MoodInBME/Hardware-Connections/enclosure/cad/MoodIN_Ver5.stp

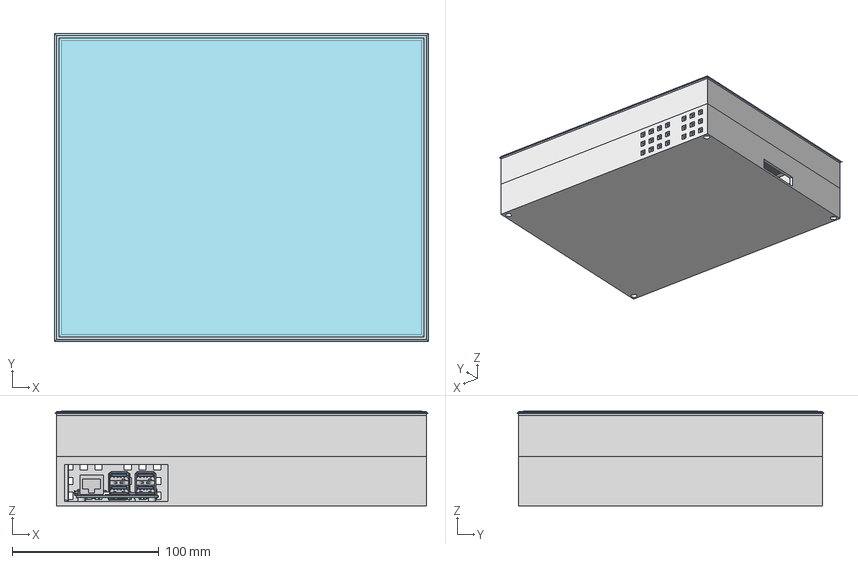
[picture p2: CAD file, 2026-07-27]
enclosure/cad/MoodIN_Ver5.stp
255.0 x 210.0 x 64.5 mm
IMX477_ElectronicCard
IMX477_BasisCamera
