MoodInBME/Hardware-Connections/enclosure/stl/top_frame01.stl

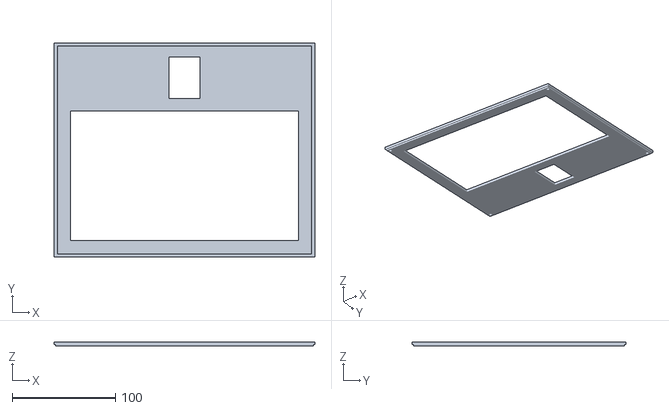
[picture p3: CAD file, 2026-07-26]
enclosure/stl/top_frame01.stl
252.3 x 207.3 x 4.30
