MoodInBME/Hardware-Connections/enclosure/cad/Top_Frame (3).stp

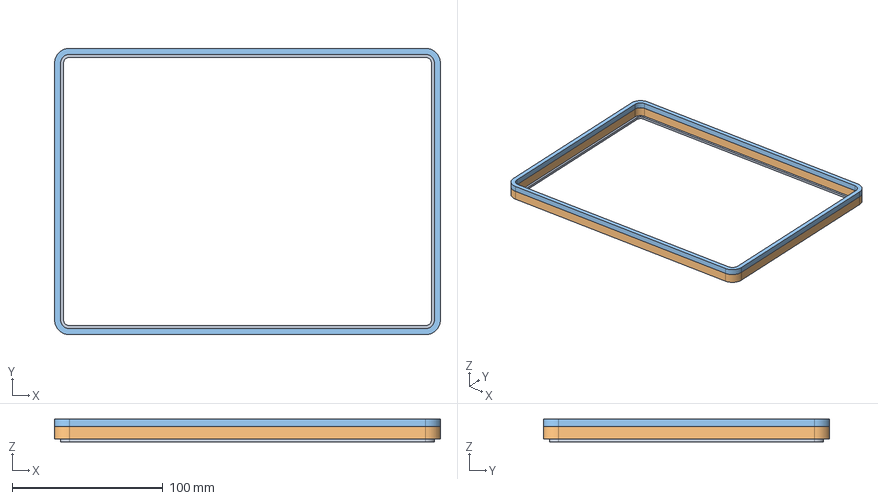
[picture p4: CAD file, 2026-07-23]
enclosure/cad/Top_Frame (3).stp
256.0 x 190.0 x 15.0 mm
