MoodInBME/Hardware-Connections/enclosure/stl/mid_frame01.stl

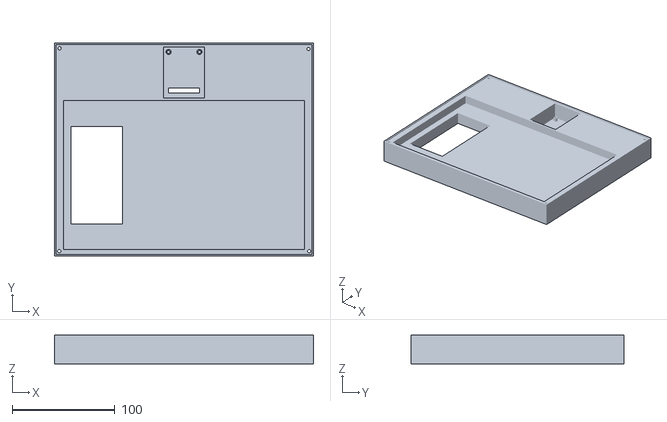
[picture p5: CAD file, 2026-07-26]
enclosure/stl/mid_frame01.stl
252.3 x 207.3 x 28.0
