MoodInBME/Hardware-Connections/enclosure/stl/body_enclosure11.stl

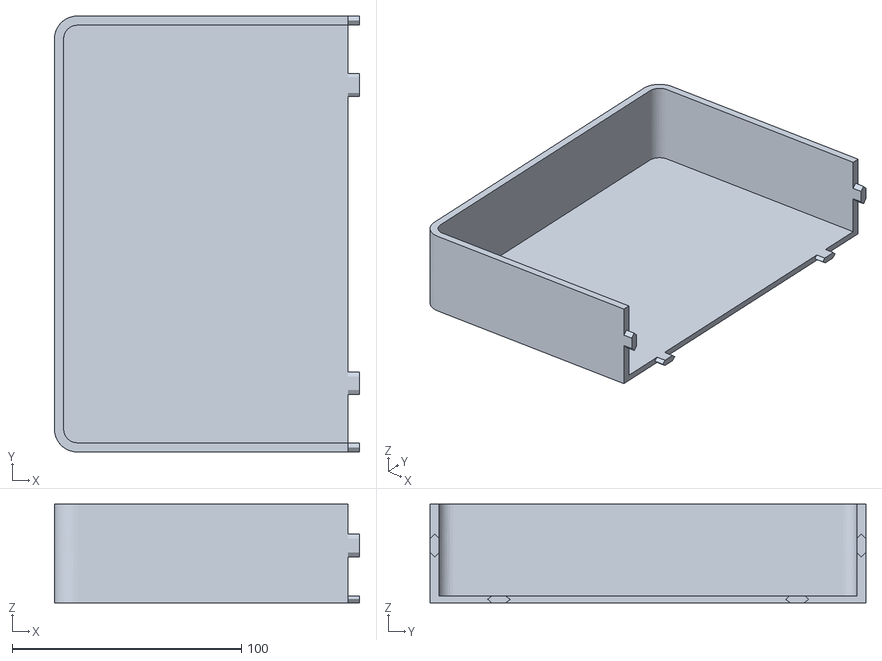
[picture p6: CAD file, 2026-07-24]
enclosure/stl/body_enclosure11.stl
133.0 x 190.0 x 43.0
