MoodInBME/Hardware-Connections/enclosure/stl/body_enclosure12.stl

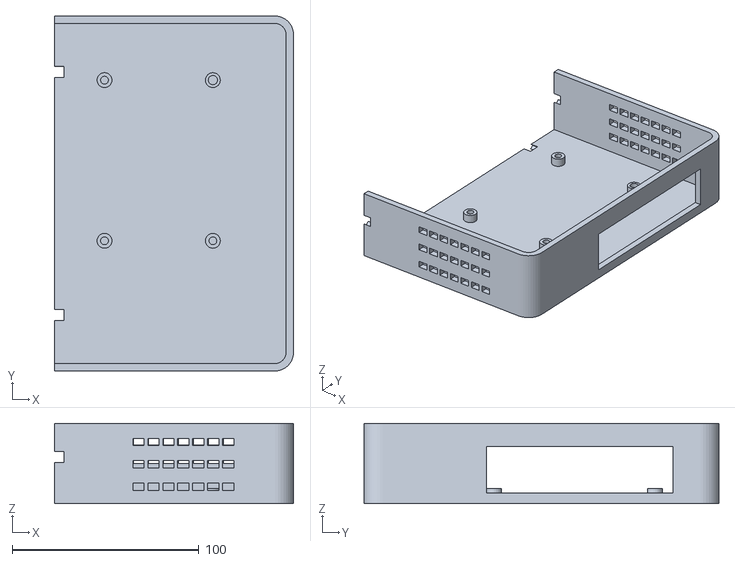
[picture p7: CAD file, 2026-07-24]
enclosure/stl/body_enclosure12.stl
128.0 x 190.0 x 43.0
