MoodInBME/Hardware-Connections/enclosure/stl/base_enclosure1.stl

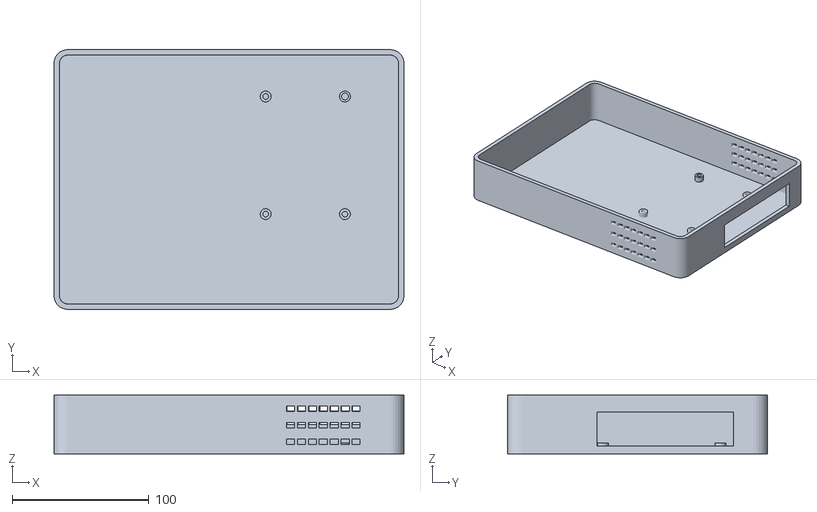
[picture p8: CAD file, 2026-07-22]
enclosure/stl/base_enclosure1.stl
256.0 x 190.0 x 43.0
