MoodInBME/Hardware-Connections/enclosure/stl/base_enclosure2.stl

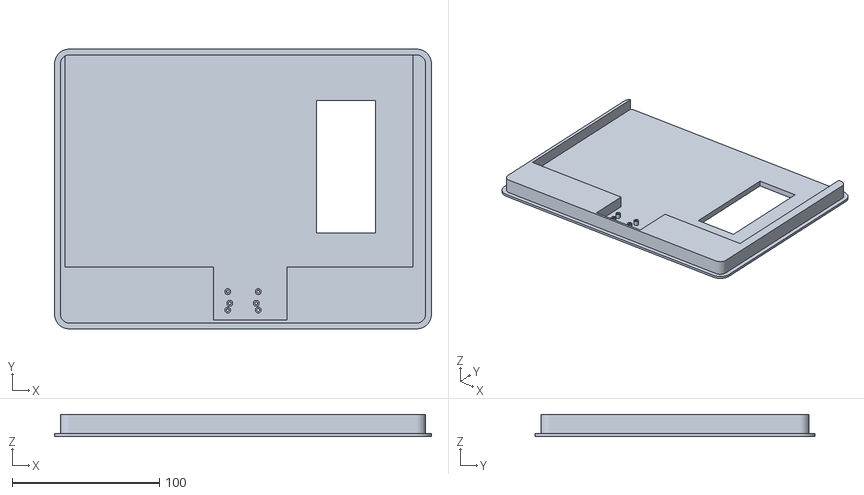
[picture p9: CAD file, 2026-07-22]
enclosure/stl/base_enclosure2.stl
256.0 x 190.0 x 15.0
