MoodInBME/Hardware-Connections/(list of files, cad)

Other CAD files:
enclosure/stl/Top_Frame.stl
