MoodInBME/Hardware-Connections/(commit log)

2026-07-22 chores: menambahkan file konfigurasi hardware dan panduannya
    [Top_Frame.stl, base_enclosure1.stl, base_enclosure2.stl, full-bom.csv, measured-current-log.csv]
2026-07-23 chores: inisialisai cad design
    [Top_Frame (3).stp]
2026-07-24 chores: revisi body enclosure untuk dibagi vertikal menjadi 2 bagian
    [body_enclosure11.stl, body_enclosure12.stl]
2026-07-26 chores: revisi stl
    [mid_frame01.stl, top_frame01.stl]
2026-07-27 chores: menambahkan revisi 3d casing
    [MoodIN_Ver5.stp]
2026-08-03 docs: sinkronisasi spesifikasi Jetson Orin Nano Super dan pembaruan README
    [full-bom.csv]
2026-10-27 docs: README fase TA dan tandai dokumen MQTT TLS sebagai arsip
    README memuat peran repo pada fase TA, termasuk integrasi dan deployment Jetson, status komponen, dan status dokumen. Dokumen MQTT TLS dan skema topik v1.0.0 ditandai arsip karena fase TA memakai MQTT lokal tanpa TLS (ADR-10 di MoodIn-master). Menambah CHANGELOG dan .gitignore.
2026-10-29 docs(etik): rekaman uji kamera tidak di-commit
    README menegaskan bahwa frame dan rekaman uji kamera yang memuat wajah disimpan di luar repo atau di folder _rekaman. .gitignore menambah pola folder data partisipan dan rekaman uji. Bagian dari Fase C1 (lintas repo, ADR-14 di MoodIn-master).
